S2JV/trabajo_fin_de_grado/01 - Simulaciones PSpice for TI 2024/01 - Resistencia de Shunt/002_offset_ai/002_OFFSET_AI.png

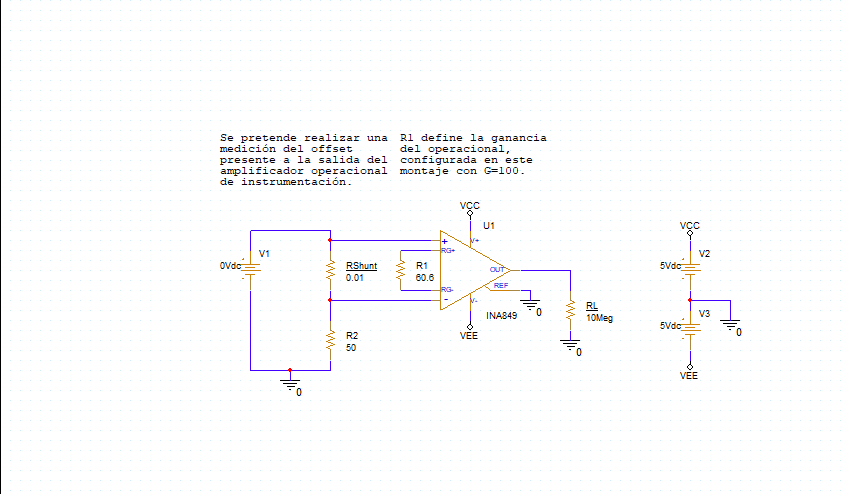
01 - Simulaciones PSpice for TI 2024/01 - Resistencia de Shunt/002_offset_ai/002_OFFSET_AI.png
