S2JV/trabajo_fin_de_grado/01 - Simulaciones PSpice for TI 2024/01 - Resistencia de Shunt/03_offset_ai_comp/03_OFFSET_AI_COMP.png

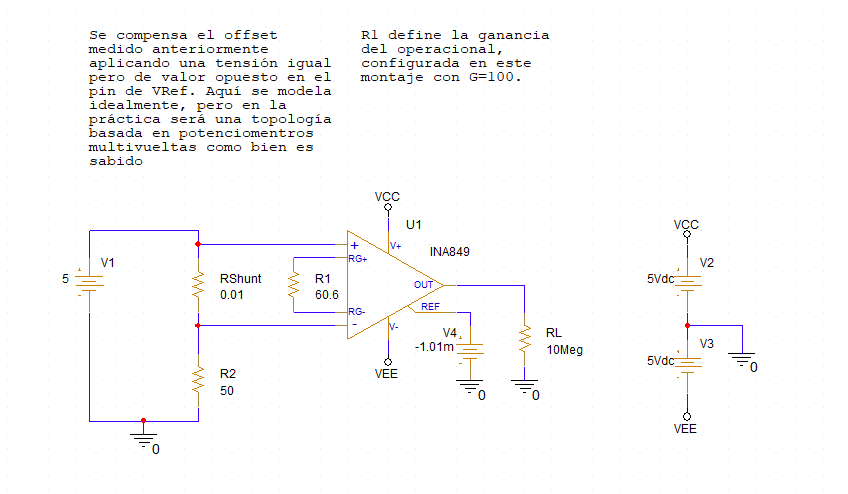
01 - Simulaciones PSpice for TI 2024/01 - Resistencia de Shunt/03_offset_ai_comp/03_OFFSET_AI_COMP.png
