S2JV/trabajo_fin_de_grado/01 - Simulaciones PSpice for TI 2024/01 - Resistencia de Shunt/004_corrientes_etapas/004_CORRIENTES_ETAPAS.png

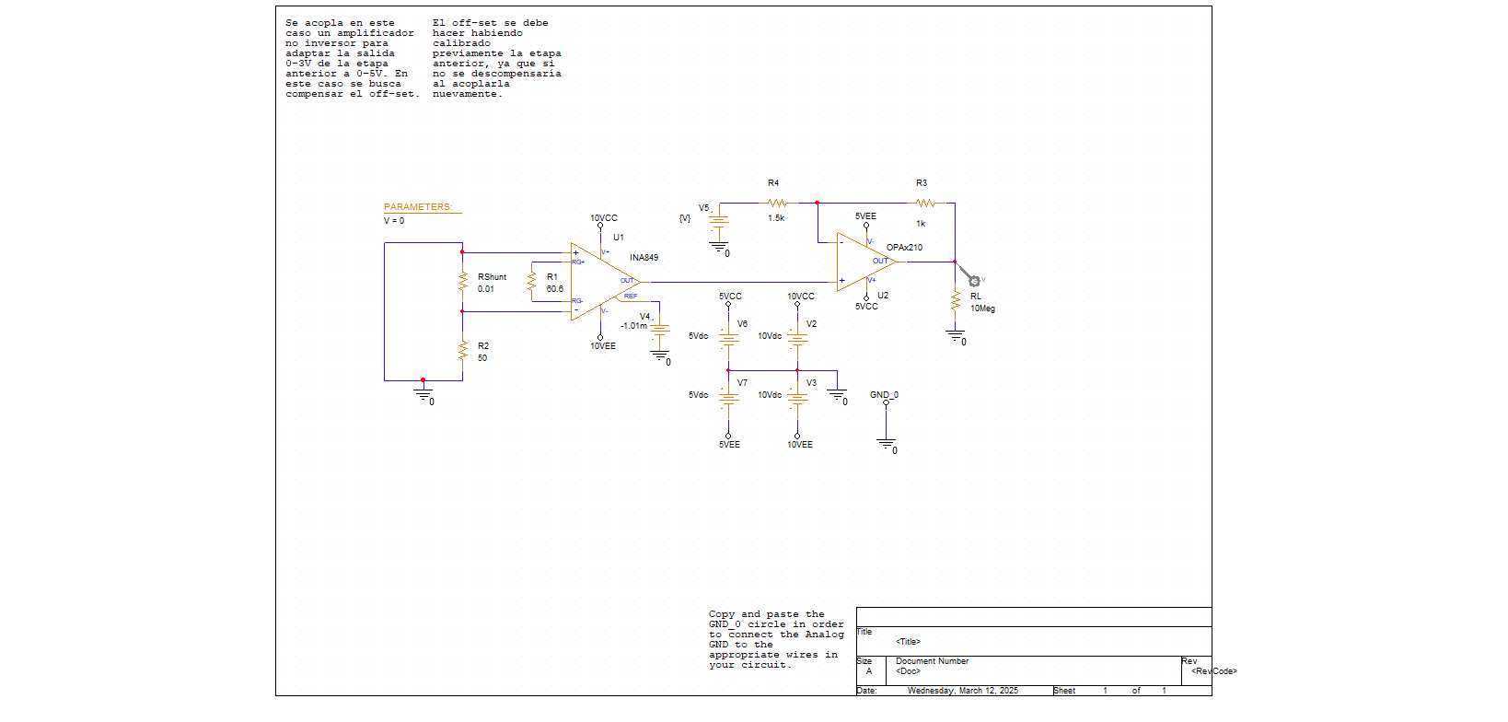
01 - Simulaciones PSpice for TI 2024/01 - Resistencia de Shunt/004_corrientes_etapas/004_CORRIENTES_ETAPAS.png
