S2JV/trabajo_fin_de_grado/01 - Simulaciones PSpice for TI 2024/01 - Resistencia de Shunt/005_corrientes_sim/005_CORREINES_SIM.png

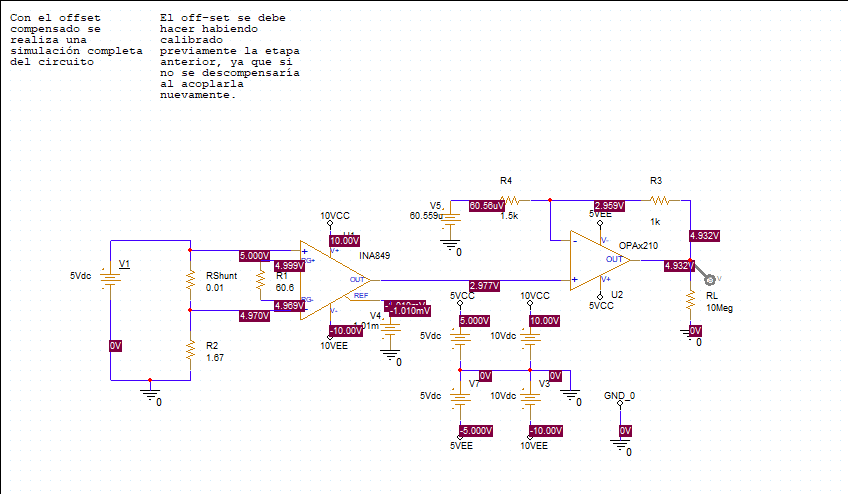
01 - Simulaciones PSpice for TI 2024/01 - Resistencia de Shunt/005_corrientes_sim/005_CORREINES_SIM.png
