S2JV/trabajo_fin_de_grado/01 - Simulaciones PSpice for TI 2024/02 - Voltímetro/001_dos_etapas_ideal/001_DOS_ETAPAS_IDEAL.png

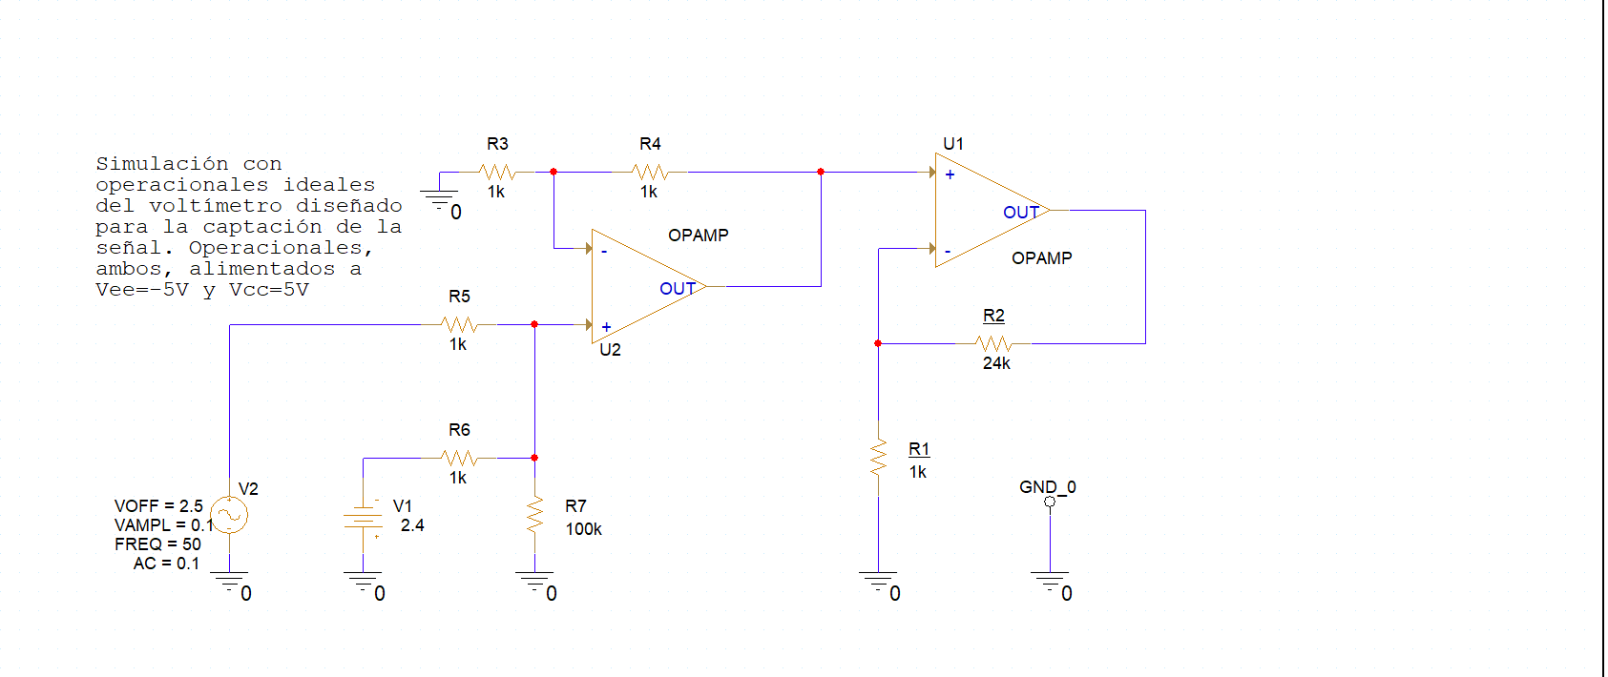
01 - Simulaciones PSpice for TI 2024/02 - Voltímetro/001_dos_etapas_ideal/001_DOS_ETAPAS_IDEAL.png
