S2JV/trabajo_fin_de_grado/01 - Simulaciones PSpice for TI 2024/02 - Voltímetro/002_dos_etapas_real/002_DOS_ETAPAS_REAL.png

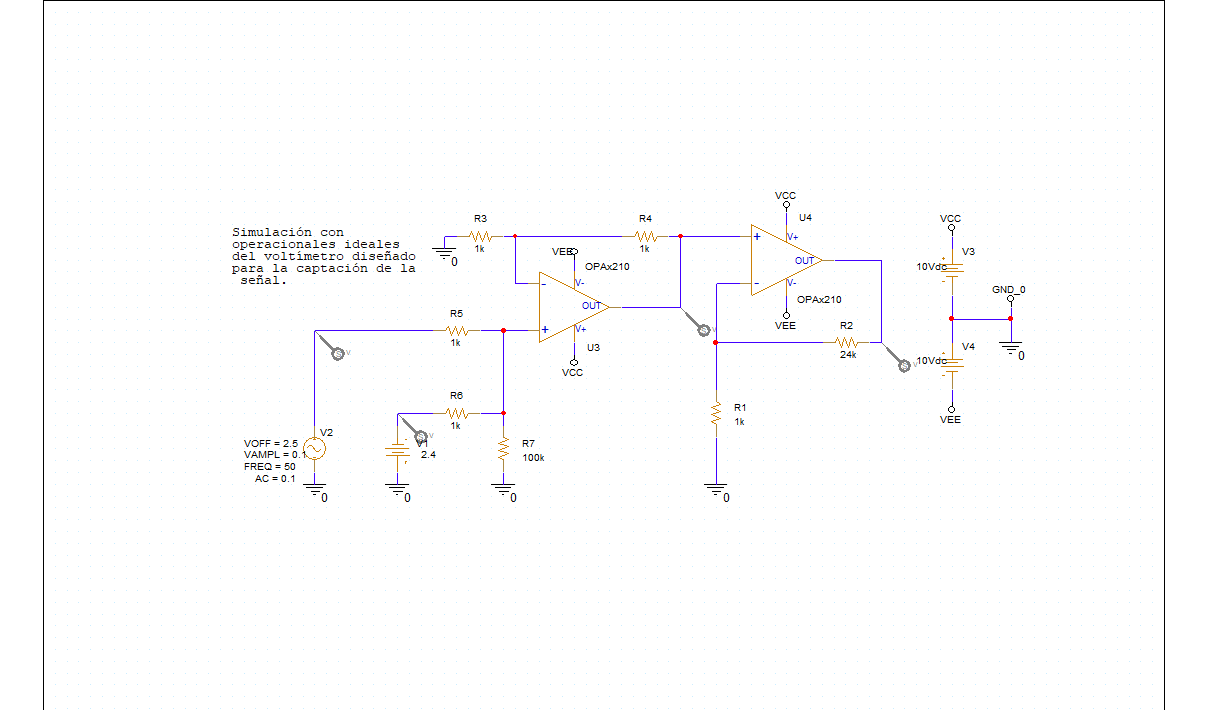
01 - Simulaciones PSpice for TI 2024/02 - Voltímetro/002_dos_etapas_real/002_DOS_ETAPAS_REAL.png
