S2JV/trabajo_fin_de_grado/01 - Simulaciones PSpice for TI 2024/02 - Voltímetro/003_etapa_uno_medicion_offset/003_ETAPA_UNO_MEDICION_OFFSET.png

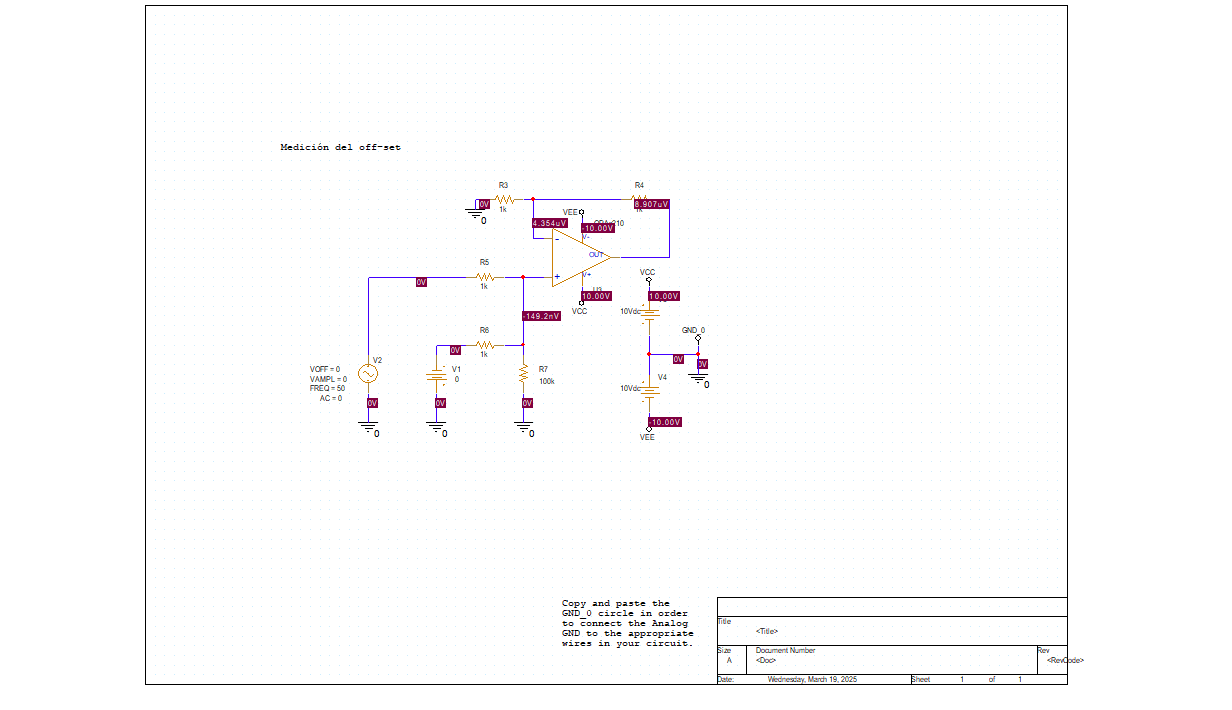
01 - Simulaciones PSpice for TI 2024/02 - Voltímetro/003_etapa_uno_medicion_offset/003_ETAPA_UNO_MEDICION_OFFSET.png
