S2JV/trabajo_fin_de_grado/01 - Simulaciones PSpice for TI 2024/02 - Voltímetro/004_etapa_uno_compensacion_offset/004_ETAPA_UNO_COMPENSACION_OFFSET.png

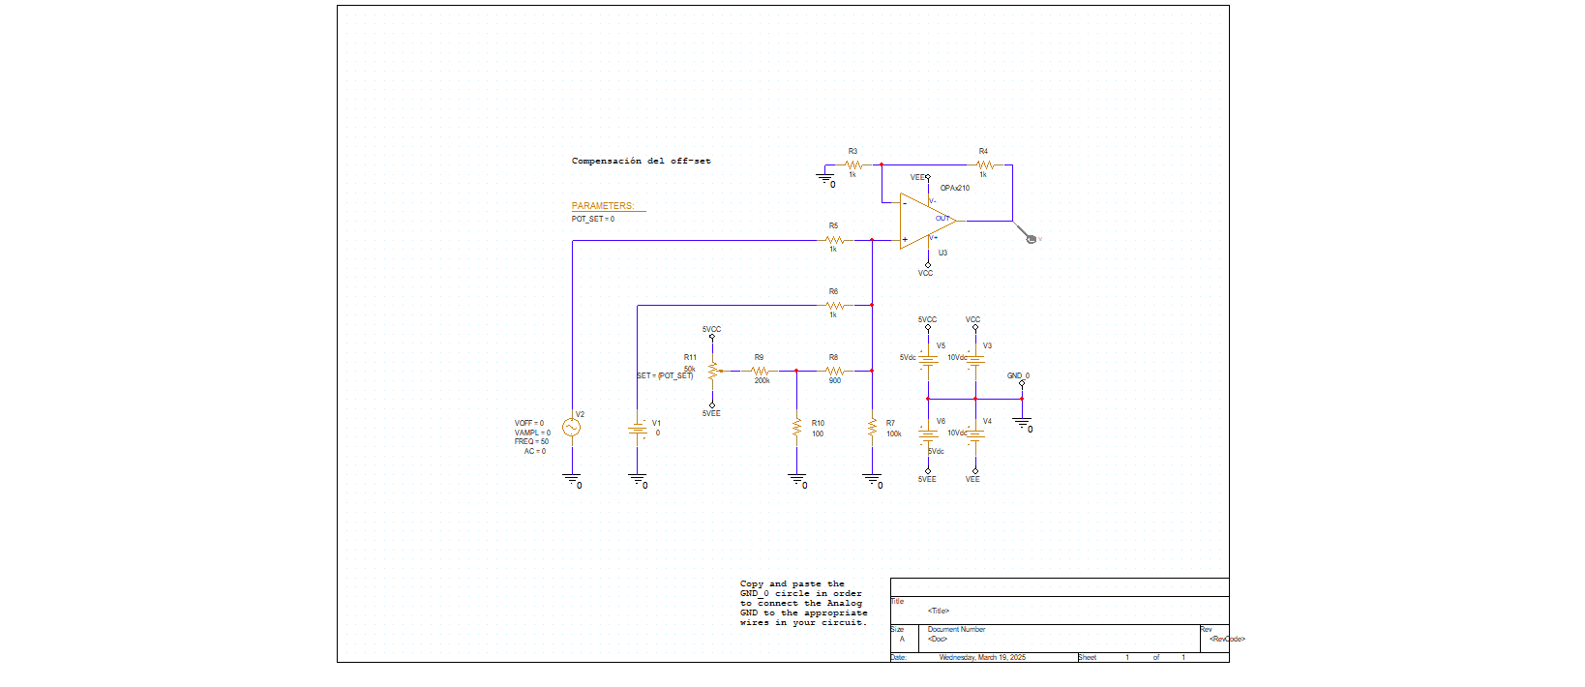
01 - Simulaciones PSpice for TI 2024/02 - Voltímetro/004_etapa_uno_compensacion_offset/004_ETAPA_UNO_COMPENSACION_OFFSET.png
