S2JV/trabajo_fin_de_grado/01 - Simulaciones PSpice for TI 2024/02 - Voltímetro/005_etapa_uno_compensado_sim/005_ETAPA_UNO_COMPENSADO_SIM.png

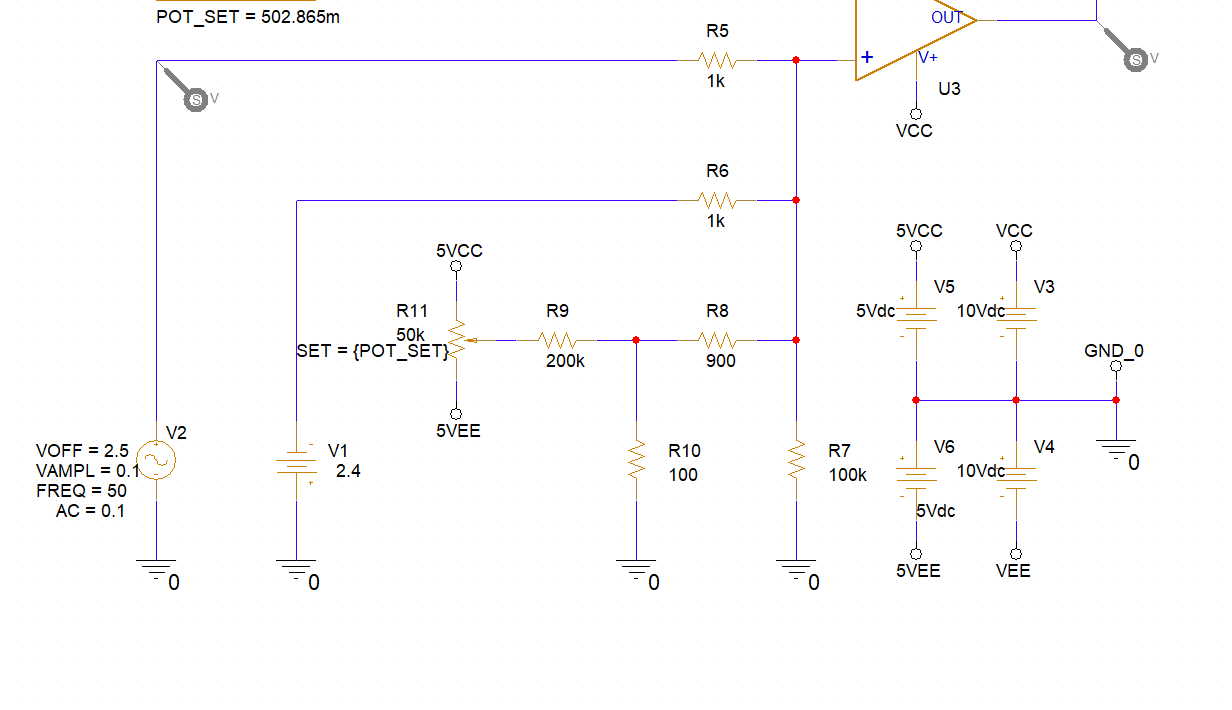
01 - Simulaciones PSpice for TI 2024/02 - Voltímetro/005_etapa_uno_compensado_sim/005_ETAPA_UNO_COMPENSADO_SIM.png
