S2JV/trabajo_fin_de_grado/(list of files, drawings)

Other design files:
01 - Simulaciones PSpice for TI 2024/01 - Resistencia de Shunt/002_offset_ai/002_offset_ai.dsn
01 - Simulaciones PSpice for TI 2024/01 - Resistencia de Shunt/002_offset_ai/002_offset_ai.opj
01 - Simulaciones PSpice for TI 2024/01 - Resistencia de Shunt/03_offset_ai_comp/03_offset_ai_comp.dsn
01 - Simulaciones PSpice for TI 2024/01 - Resistencia de Shunt/03_offset_ai_comp/03_offset_ai_comp.opj
01 - Simulaciones PSpice for TI 2024/01 - Resistencia de Shunt/004_corrientes_etapas/004_corrientes_etapas.dsn
01 - Simulaciones PSpice for TI 2024/01 - Resistencia de Shunt/004_corrientes_etapas/004_corrientes_etapas.opj
01 - Simulaciones PSpice for TI 2024/01 - Resistencia de Shunt/005_corrientes_sim/005_correines_sim.dsn
01 - Simulaciones PSpice for TI 2024/01 - Resistencia de Shunt/005_corrientes_sim/005_correines_sim.opj
01 - Simulaciones PSpice for TI 2024/02 - Voltímetro/001_dos_etapas_ideal/001_dos_etapas_ideal.dsn
01 - Simulaciones PSpice for TI 2024/02 - Voltímetro/001_dos_etapas_ideal/001_dos_etapas_ideal.opj
01 - Simulaciones PSpice for TI 2024/02 - Voltímetro/002_dos_etapas_real/002_dos_etapas_real.dsn
01 - Simulaciones PSpice for TI 2024/02 - Voltímetro/002_dos_etapas_real/002_dos_etapas_real.opj
01 - Simulaciones PSpice for TI 2024/02 - Voltímetro/003_etapa_uno_medicion_offset/003_etapa_uno_medicion_offset.dsn
01 - Simulaciones PSpice for TI 2024/02 - Voltímetro/003_etapa_uno_medicion_offset/003_etapa_uno_medicion_offset.opj
01 - Simulaciones PSpice for TI 2024/02 - Voltímetro/004_etapa_uno_compensacion_offset/004_etapa_uno_compensacion_offset.dsn
01 - Simulaciones PSpice for TI 2024/02 - Voltímetro/004_etapa_uno_compensacion_offset/004_etapa_uno_compensacion_offset.opj
01 - Simulaciones PSpice for TI 2024/02 - Voltímetro/005_etapa_uno_compensado_sim/005_etapa_uno_compensado_sim.dsn
01 - Simulaciones PSpice for TI 2024/02 - Voltímetro/005_etapa_uno_compensado_sim/005_etapa_uno_compensado_sim.opj
