S2JV/trabajo_fin_de_grado/04 - Archivos Fabricación/01 - Sistema de Medición/02 - KiCAD Board/rev_main_A.kicad_pcb

## KiCad design 04 - Archivos Fabricación/01 - Sistema de Medición/02 - KiCAD Board/rev_main_A.kicad_pcb (2025-11-10)

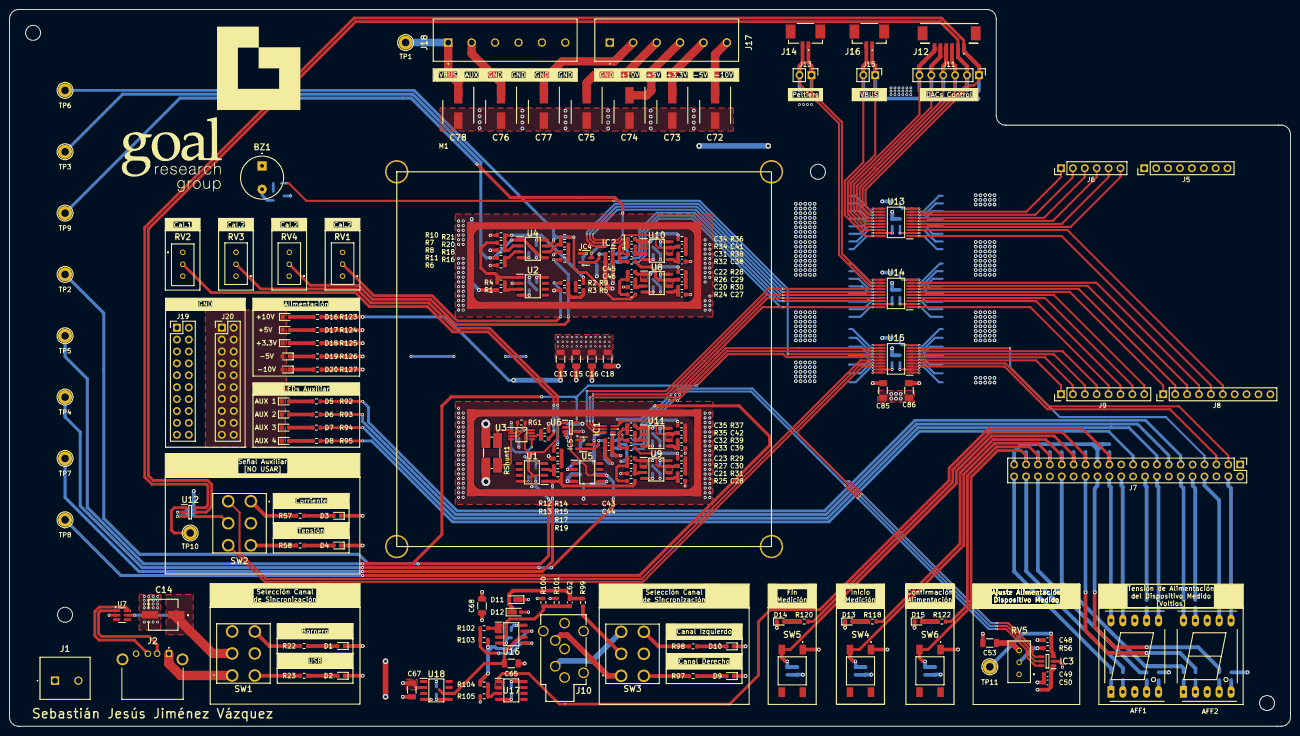
[picture p10: board rev_main_A.kicad_pcb from above]

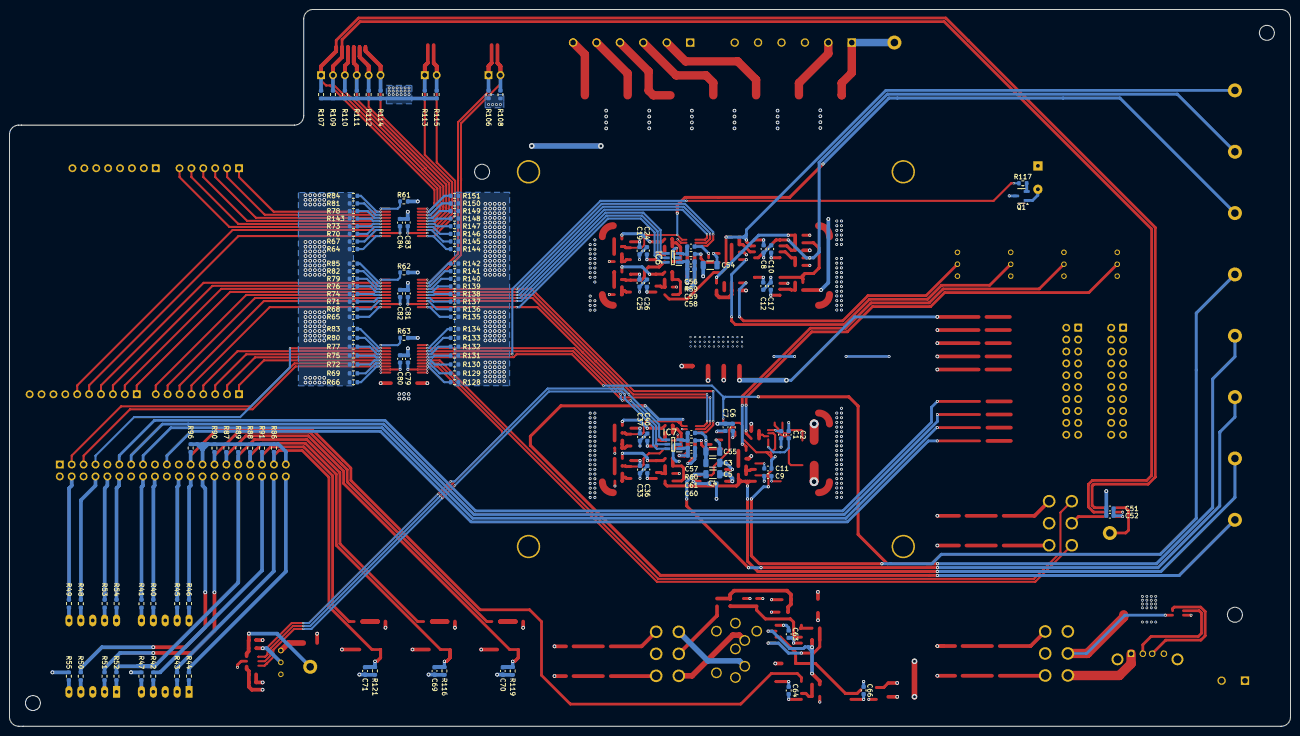
[picture p11: board rev_main_A.kicad_pcb from below]

Board: 4 copper layers, 273.5 x 153.0 mm, 334 parts (134 on the bottom side), 197 nets.

Parts:
AFF1, AFF2: TDSR1050; 7SegmentLED_LTS6760_LTS6780
BZ1: CMI-0955-05TH
C1, C2, C6, C7, C8, C9, C10, C11, C12, C17, C19, C24, C25, C26, C33, C36, C37, C40, C43, C45, C49, C51, C56, C57, C58, C60, C63, C64, C79, C80, C81, C82, C83, C84: 0.1u; C_0603_1608Metric
C3, C13, C15, C16, C18, C53, C54, C55, C65, C67, C68: 10u; C_1206_3216Metric
C4, C44, C46, C50, C52, C59, C61, C62, C66, C69, C70, C71: 1u; C_0603_1608Metric
C5: 47u; C_1206_3216Metric
C14: 100u; 865080343009
C20, C21: 100p; C_0603_1608Metric
C22, C23, C29, C30, C34, C35, C41, C42: 1n; C_0603_1608Metric
C27, C28: 430p; C_0603_1608Metric
C31, C32: 680p; C_0603_1608Metric
C38, C39: 910p; C_0603_1608Metric
C48: 15n; C_0603_1608Metric
C72, C73, C74, C75, C76, C77, C78: 47u; CAPAE660X770N
C85, C86: 10u; C_1206_3216Metric_Pad1.33x1.80mm_HandSolder
D1, D2, D3, D4, D5, D6, D7, D8, D9, D10, D13, D15: LED (G); LED_0603_1608Metric
D11, D12: 1V; D_MicroSMP_AK
D14, D16, D17, D18, D19, D20: LED (R); LED_0603_1608Metric
H1, H2, H3, H4: MountingHole; MountingHole_3.2mm_M3
IC1, IC2: AD7476AAKSZ-REEL7; AD7476AAKSZ
IC3, IC6, IC7: ADC121S021CIMFX/NOPB; ADC121S021CIMFXNOPB
IC4, IC5: TMP235A2DBZR; SOT-23-3
J1: Screw_Terminal_01x02; Screw Terminal 2P
J2: USB-1125-GF-B; USB1125GFB [USBA]
J3, J4: MS488-10C
J5: Arduino Power Shield; PinHeader_1x08_P2.54mm_Vertical
J6: Arduino Analog Shield; PinHeader_1x06_P2.54mm_Vertical
J7: Raspberry Pi Shield; PinHeader_2x20_P2.54mm_Vertical
J8: Arduino Digital Shield II; PinHeader_1x10_P2.54mm_Vertical
J9: Arduino Digital Shield I; PinHeader_1x08_P2.54mm_Vertical
J10: SJ1-3533NS; Conector Jack - SJ1-3533NS
J11: Pines; PinHeader_1x06_P2.54mm_Vertical
J12: PicoBlade 6P
J13, J15: PinHeader_1x02_P2.54mm_Vertical
J14, J16: PicoBlade 2P
J17, J18: Screw_Terminal_01x06; Screw Terminal 6P
J19, J20: Conn_02x07_Top_Bottom; PinHeader_2x10_P2.54mm_Vertical
M1: Fan; MC002110
Q1: MMBT4401; SOT-23-3
R1, R4, R6, R7, R8, R11, R19, R40, R41, R42, R43, R44, R45, R46, R47, R48, R49, R50, R51, R52, R53, R54, R55, R116, R117, R119, R121: 1k; R_0603_1608Metric
R2, R13, R14, R16: 200k; R_0603_1608Metric
R3, R12, R15, R18, R59, R60: 100; R_0603_1608Metric
R5, R20: 900; R_0603_1608Metric
R9, R99: 0; R_0603_1608Metric
R10, R103, R105: 100k; R_0603_1608Metric
R17: 1k4; R_0603_1608Metric
R21: 24k; R_0603_1608Metric
R22, R23, R57, R58, R92, R93, R94, R95, R97, R98, R118, R120, R122, R125: 130; R_0603_1608Metric
R24, R25: 1.1k; R_0603_1608Metric
R26, R27: 4.87k; R_0603_1608Metric
R28, R29: 845; R_0603_1608Metric
R30, R31: 1.82k; R_0603_1608Metric
R32, R33: 698; R_0603_1608Metric
R34, R35: 1.58k; R_0603_1608Metric
R36, R37: 715; R_0603_1608Metric
R38, R39: 1.21k; R_0603_1608Metric
R56, R61, R62, R63, R64, R65, R66, R67, R68, R69, R70, R71, R72, R73, R74, R75, R76, R77, R78, R79, R80, R81, R82, R83, R84, R85, R86, R87, R88, R89, R90, R91, R96, R102, R128, R129, R130, R131, R132, R133, R134, R135, R136, R137, R138, R139, R140, R141, R142, R143, R144, R145, R146, R147, R148, R149, R150, R151: 10k; R_0603_1608Metric
R100, R101: 32k; R_0603_1608Metric
R104: 51.5k; R_0603_1608Metric
R106, R107, R108, R109, R110, R111, R112, R113, R114, R115: R; R_0603_1608Metric
R123, R126: 800; R_0603_1608Metric
R124, R127: 300; R_0603_1608Metric
RG1: 60.6; R_0603_1608Metric
RShunt1: 10m; R_Shunt_Ohmite_LVK24
RV1, RV2, RV3, RV4, RV5: 50k; PV36W201C01B00
SW1, SW2, SW3: 100DP1T1B1M2QEH; SW Palanca 100DP1T1B1M2QEH
SW4, SW5, SW6: SW_Push; SW Tactile
TP1, TP2, TP3, TP4, TP5, TP6, TP7, TP8, TP9, TP10, TP11: TestPoint; TestPoint_Loop_D2.60mm_Drill1.6mm_Beaded
U1, U2, U4, U16, U17: OPA210IDBVR; OPA2107AU2K5
U3: INA849DGKT
U5: REF5030AIDR
U6: TLV3601QDBVRQ1
U7: IP4234CZ6,125; SC-74-6_1.55x2.9mm_P0.95mm
U8, U9, U10, U11: AD8656ARZ
U12: DAC121S101CIMK_NOPB
U13, U14, U15: TXS0108EPWRG4
U18: REF5025AIDR; REF5030AIDR

Connections:
+3.3V: C74.1, C80.1, C82.1, C84.1, C86.1, J5.5, J5.7, J7.1, J7.17, J17.4, R47.1, R61.1, R62.1, R63.1, R125.2, SW1.5 (B), SW2.2 (B), SW3.5 (B), SW4.1, SW5.1, SW6.1, U13.2 (VCCA), U14.2 (VCCA), U15.2 (VCCA)
+5V: BZ1.1 (+), C3.1, C6.1, C16.1, C19.1, C25.1, C33.1, C37.1, C43.2, C44.2, C45.2, C46.2, C49.2, C50.2, C51.2, C52.2, C53.1, C54.1, C55.1, C58.2, C59.2, C60.2, C61.2, C63.1, C64.1, C67.1, C68.1, C75.1, C79.1, C81.1, C83.1, C85.1, IC1.1 (VDD), IC2.1 (VDD), IC3.1 (VDD), IC4.1 (VDD), IC5.1 (VDD), IC6.1 (VDD), IC7.1 (VDD), J5.4, J7.2, J17.3, R100.1, R124.2, RV1.1, RV2.3, RV3.1, RV4.1, RV5.3, U5.2 (Vin), U6.3 (V+), U8.8 (V+), U9.8 (V+), U10.8 (V+), U11.8 (V+), U12.3 (VA), U13.19 (VCCB), U14.19 (VCCB), U15.19 (VCCB), U16.8 (V+), U17.8 (V+), U18.2 (Vin)
+10V: C1.2, C8.1, C9.1, C12.1, C13.1, C77.1, J17.2, R123.2, U1.8 (V+), U2.8 (V+), U3.8 (Vs+), U4.8 (V+)
-5V: C7.1, C18.1, C24.1, C26.1, C36.1, C40.1, C73.1, J17.5, R127.2, RV1.3, RV2.1, RV3.3, RV4.3, U6.4 (V-), U8.4 (V-), U9.4 (V-), U10.4 (V-), U11.4 (V-)
-10V: C2.2, C10.1, C11.1, C15.1, C17.1, C72.1, J17.6, R126.2, U1.4 (V-), U2.4 (V-), U3.5 (Vs-), U4.4 (V-)
/006_Conn_FPGA1/BUZZER_{FPGA}: J9.3, R77.1, U15.7 (A6)
/006_Conn_FPGA1/CD_{BUS,ADC,FPGA}: J9.5, R65.1, U14.1 (A1)
/006_Conn_FPGA1/CLK_{4MHz,FPGA}: J9.7, R71.1, U14.4 (A3)
/006_Conn_FPGA1/CLK_{ADC,FPGA}: J9.8, R74.1, U14.5 (A4)
/006_Conn_FPGA1/CLK_{DAC,FPGA}: J6.2, R81.1, U13.8 (A7)
/006_Conn_FPGA1/CS_{ADC,FPGA}: J8.2, R79.1, U14.7 (A6)
/006_Conn_FPGA1/DATA_{BUS,ADC,FPGA}: J7.5, R66.1, U15.3 (A2)
/006_Conn_FPGA1/DATA_{I,ADC,FPGA}: J9.4, R80.1, U15.8 (A7)
/006_Conn_FPGA1/DATA_{TEMP,I,FPGA}: J7.7, R83.1, U15.9 (A8)
/006_Conn_FPGA1/DATA_{TEMP,V,FPGA}: J9.6, R68.1, U14.3 (A2)
/006_Conn_FPGA1/DATA_{V,ADC,FPGA}: J8.1, R76.1, U14.6 (A5)
/006_Conn_FPGA1/DIN_{DAC,AUX,FPGA}: J6.6, R70.1, U13.4 (A3)
/006_Conn_FPGA1/DIN_{DAC,BUS,FPGA}: J6.5, R73.1, U13.5 (A4)
/006_Conn_FPGA1/DIN_{DAC,PEL,I,FPGA}: J6.3, R78.1, U13.7 (A6)
/006_Conn_FPGA1/DIN_{DAC,PEL,V,FPGA}: J6.4, R143.1, U13.6 (A5)
/006_Conn_FPGA1/DIN_{I,AUX,FPGA}: J7.3, R69.1, U15.4 (A3)
/006_Conn_FPGA1/DIN_{V,AUX,FPGA}: J9.1, R72.1, U15.5 (A4)
/006_Conn_FPGA1/ENABLE_{BUS,AUX,FPGA}: J8.6, R67.1, U13.3 (A2)
/006_Conn_FPGA1/ENABLE_{BUS,FPGA}: J8.5, R64.1, U13.1 (A1)
/006_Conn_FPGA1/ENABLE_{PEL,I,FPGA}: J8.4, R85.1, U14.9 (A8)
/006_Conn_FPGA1/ENABLE_{PEL,V,FPGA}: J8.3, R82.1, U14.8 (A7)
/006_Conn_FPGA1/LED_{AUX,1}: J7.11, R92.2
/006_Conn_FPGA1/LED_{AUX,2}: J7.13, R93.2
/006_Conn_FPGA1/LED_{AUX,3}: J7.15, R94.2
/006_Conn_FPGA1/LED_{AUX,4}: J7.19, R95.2
/006_Conn_FPGA1/Protection_{Trigger,FPGA}: J9.2, R75.1, U15.6 (A5)
/006_Conn_FPGA1/SYNC_{DAC,FPGA}: J6.1, R84.1, U13.9 (A8)
ADC_{I,In}: C42.2, IC1.3 (VIN), TP8.1, U11.6 (-), U11.7
ADC_{V,In}: C41.2, IC2.3 (VIN), TP9.1, U10.6 (-), U10.7
BUZZER: R117.2, R132.1, U15.14 (B6)
CLK_{4MHz}: IC3.4 (SCLK), IC6.4 (SCLK), IC7.4 (SCLK), R137.1, U14.17 (B3)
CLK_{ADC}: IC1.4 (SCLK), IC2.4 (SCLK), R138.1, U14.16 (B4)
CLK_{DAC}: J11.2, J12.2, R109.1, R150.1, U12.5 (SCLK), U13.13 (B7)
CS_{ADC}: IC1.6 (~CS), IC2.6 (~CS), R140.1, U14.14 (B6)
CS_{BUS,ADC}: IC3.6 (~CS), IC6.6 (~CS), IC7.6 (~CS), R135.1, U14.20 (B1)
DATA_{BUS,ADC}: IC3.5 (SDATA), R128.1, U15.18 (B2)
DATA_{I,ADC}: IC1.5 (SDATA), R133.1, U15.13 (B7)
DATA_{TEMP,I}: IC7.5 (SDATA), R134.1, U15.12 (B8)
DATA_{TEMP,V}: IC6.5 (SDATA), R136.1, U14.18 (B2)
DATA_{V,ADC}: IC2.5 (SDATA), R139.1, U14.15 (B5)
DIN_{DAC,AUX}: J11.6, J12.6, R114.1, R146.1, U13.17 (B3)
DIN_{DAC,BUS}: J11.5, J12.5, R112.1, R147.1, U13.16 (B4)
DIN_{DAC,PEL,I}: J11.3, J12.3, R110.1, R149.1, U13.14 (B6)
DIN_{DAC,PEL,V}: J11.4, J12.4, R111.1, R148.1, U13.15 (B5)
DIN_{I,AUX}: R129.1, SW2.6 (C), U15.17 (B3)
DIN_{V,AUX}: R130.1, SW2.4 (A), U15.16 (B4)
Display1_{a}: J7.18, R40.1
Display1_{b}: J7.16, R41.1
Display1_{c}: J7.36, R42.1
Display1_{d}: J7.38, R43.1
Display1_{e}: J7.40, R44.1
Display1_{f}: J7.22, R45.1
Display1_{g}: J7.24, R46.1
Display2_{a}: J7.8, R48.1
Display2_{b}: J7.4, R49.1
Display2_{c}: J7.26, R50.1
Display2_{d}: J7.28, R51.1
Display2_{e}: J7.32, R52.1
Display2_{f}: J7.10, R53.1
Display2_{g}: J7.12, R54.1
ENABLE_{BUS,AUX}: J15.1, J16.1, R113.1, R145.1, U13.18 (B2)
ENABLE_{BUS}: J15.2, J16.2, R115.1, R144.1, U13.20 (B1)
ENABLE_{PEL,I}: J13.1, J14.1, R106.1, R142.1, U14.12 (B8)
ENABLE_{PEL,V}: J13.2, J14.2, R108.1, R141.1, U14.13 (B7)
GND: AFF1.3 (C.A.), AFF1.8 (C.A.), AFF2.3 (C.A.), AFF2.8 (C.A.), C1.1, C2.1, C3.2, C4.2, C5.2, C6.2, C7.2, C8.2, C9.2, C10.2, C11.2, C12.2, C13.2, C14.2, C15.2, C16.2, C17.2, C18.2, C19.2, C20.2, C21.2, C24.2, C25.2, C26.2, C27.2, C28.2, C31.2, C32.2, C33.2, C36.2, C37.2, C38.2, C39.2, C40.2, C43.1, C44.1, C45.1, C46.1, C48.2, C49.1, C50.1, C51.1, C52.1, C53.2, C54.2, C55.2, C56.2, C57.2, C58.1, C59.1, C60.1, C61.1, C63.2, C64.2, C65.2, C66.2, C67.2, C68.2, C69.2, C70.2, C71.2, C72.2, C73.2, C74.2, C75.2, C76.2, C77.2, C78.2, C79.2, C80.2, C81.2, C82.2, C83.2, C84.2, C85.2, C86.2, D1.1 (K), D2.1 (K), D3.1 (K), D4.1 (K), D5.1 (K), D6.1 (K), D7.1 (K), D8.1 (K), D9.1 (K), D10.1 (K), D11.1 (K), D12.2 (A), D13.1 (K), D14.1 (K), D15.1 (K), D16.1 (K), D17.1 (K), D18.1 (K), D19.2 (A), D20.2 (A), IC1.2 (GND), IC2.2 (GND), IC3.2 (GND), IC4.3 (GND), IC5.3 (GND), IC6.2 (GND), IC7.2 (GND), J1.1, J2.4 (GND), J2.5 (Shield), J3.1 (Shield), J4.1 (Shield), J5.2, J5.3, J7.6, J7.9, J7.14, J7.20, J7.25, J7.30, J7.34, J7.39, J8.7, J10.1, J17.1, J18.3, J18.4, J18.5, J18.6, J19.1, J19.2, J19.3, J19.4, J19.5, J19.6, J19.7, J19.8, J19.9, J19.10, J19.11, J19.12, J19.13, J19.14, J19.15, J19.16, J19.17, J19.18, J19.19, J19.20, J20.1, J20.2, J20.3, J20.4, J20.5, J20.6, J20.7, J20.8, J20.9, J20.10, J20.11, J20.12, J20.13, J20.14, J20.15, J20.16, J20.17, J20.18, J20.19, J20.20, M1.1 (+), Q1.3 (E), R3.1, R6.1, R10.1, R12.1, R15.2, R18.2, R55.1, R64.2, R65.2, R66.2, R67.2, R68.2, R69.2, R70.2, R71.2, R72.2, R73.2, R74.2, R75.2, R76.2, R77.2, R78.2, R79.2, R80.2, R81.2, R82.2, R83.2, R84.2, R85.2, R86.2, R87.2, R88.2, R89.2, R90.2, R91.2, R96.2, R101.2, R105.2, R106.2, R107.2, R108.2, R109.2, R110.2, R111.2, R112.2, R113.2, R114.2, R115.2, R116.2, R119.2, R121.2, R128.2, R129.2, R130.2, R131.2, R132.2, R133.2, R134.2, R135.2, R136.2, R137.2, R138.2, R139.2, R140.2, R141.2, R142.2, R143.2, R144.2, R145.2, R146.2, R147.2, R148.2, R149.2, R150.2, R151.2, RV5.1, U2.2 (-), U5.4 (GND), U7.2 (VN), U12.2 (GND), U13.11 (GND), U14.11 (GND), U15.11 (GND), U16.4 (V-), U17.4 (V-), U18.4 (GND)
I_{Measure}: R19.2, R25.1, TP7.1, U1.1
unnamed: AFF1.5 (DP), R47.2
unnamed: AFF1.7 (a), R40.2
unnamed: AFF1.6 (b), R41.2
unnamed: AFF1.4 (c), R42.2
unnamed: AFF1.2 (d), R43.2
unnamed: AFF1.1 (e), R44.2
unnamed: AFF1.9 (f), R45.2
unnamed: AFF1.10 (g), R46.2
unnamed: AFF2.5 (DP), R55.2
unnamed: AFF2.7 (a), R48.2
unnamed: AFF2.6 (b), R49.2
unnamed: AFF2.4 (c), R50.2
unnamed: AFF2.2 (d), R51.2
unnamed: AFF2.1 (e), R52.2
unnamed: AFF2.9 (f), R53.2
unnamed: AFF2.10 (g), R54.2
unnamed: BZ1.2 (-), Q1.1 (C)
unnamed: C22.1, R24.2, R26.1
unnamed: C23.1, R25.2, R27.1
unnamed: C29.1, R28.2, R30.1
unnamed: C30.1, R29.2, R31.1
unnamed: C34.1, R32.2, R34.1
unnamed: C35.1, R33.2, R35.1
unnamed: C41.1, R36.2, R38.1
unnamed: C42.1, R37.2, R39.1
unnamed: D1.2 (A), R22.1
unnamed: D2.2 (A), R23.1
unnamed: D3.2 (A), R57.1
unnamed: D4.2 (A), R58.1
unnamed: D5.2 (A), R92.1
unnamed: D6.2 (A), R93.1
unnamed: D7.2 (A), R94.1
unnamed: D8.2 (A), R95.1
unnamed: D9.2 (A), R97.1
unnamed: D10.2 (A), R98.1
unnamed: C62.1, D11.2 (A), D12.1 (K), R99.2
unnamed: D13.2 (A), R118.1
unnamed: D14.2 (A), R120.1
unnamed: D15.2 (A), R122.1
unnamed: D16.2 (A), R123.1
unnamed: D17.2 (A), R124.1
unnamed: D18.2 (A), R125.1
unnamed: D19.1 (K), R126.1
unnamed: D20.1 (K), R127.1
unnamed: C48.1, IC3.3 (VIN), R56.2, TP11.1
unnamed: IC4.2 (VOUT), R59.1
unnamed: IC5.2 (VOUT), R60.1
unnamed: C56.1, IC6.3 (VIN), R59.2
unnamed: C57.1, IC7.3 (VIN), R60.2
unnamed: J1.2, SW1.3 (C)
unnamed: J2.3 (D+), U7.6
unnamed: J2.2 (D-), U7.1
unnamed: J2.1 (VBUS), SW1.1 (A)
unnamed: J10.2, SW3.3 (C)
unnamed: J10.3, SW3.1 (A)
unnamed: Q1.2 (B), R117.1
unnamed: R2.1, RV1.2
unnamed: R2.2, R3.2, R5.1
unnamed: R4.2, R7.1, U2.1
unnamed: R5.2, R9.1
unnamed: R13.2, RV2.2
unnamed: R14.1, RV3.2
unnamed: R14.2, R15.1, R17.1
unnamed: R16.1, RV4.2
unnamed: R16.2, R18.1, R20.2
unnamed: R22.2, SW1.6 (C)
unnamed: R23.2, SW1.4 (A)
unnamed: R56.1, RV5.2
unnamed: R57.2, SW2.1 (A)
unnamed: R58.2, SW2.3 (C)
unnamed: R97.2, SW3.4 (A)
unnamed: R98.2, SW3.6 (C)
unnamed: R99.1, SW3.2 (B)
unnamed: R103.2, R104.1, U16.7
unnamed: RG1.1, U3.2 (Rg)
unnamed: RG1.2, U3.3 (Rg)
unnamed: R17.2, R19.1, U1.3 (+)
unnamed: TP2.1, U1.2 (-), U3.7, U6.1 (+)
unnamed: R1.2, R4.1, U2.3 (+)
unnamed: RShunt1.3, U3.4 (+)
unnamed: RShunt1.2, U3.1 (-)
unnamed: R12.2, R13.1, U3.6 (Ref)
unnamed: R6.2, R11.1, U4.3 (+)
unnamed: R7.2, R8.2, R9.2, R10.2, U4.2 (-)
unnamed: R11.2, TP3.1, U4.1, U4.5 (+)
unnamed: R20.1, R21.1, U4.6 (-)
unnamed: C4.1, U5.5 (Trim/NR)
unnamed: C5.1, TP4.1, U5.6 (Vout), U6.2 (-)
unnamed: C20.1, R26.2, U8.3 (+)
unnamed: C22.2, R28.1, U8.1, U8.2 (-)
unnamed: C27.1, R30.2, U8.5 (+)
unnamed: C29.2, R32.1, U8.6 (-), U8.7
unnamed: C21.1, R27.2, U9.3 (+)
unnamed: C23.2, R29.1, U9.1, U9.2 (-)
unnamed: C28.1, R31.2, U9.5 (+)
unnamed: C30.2, R33.1, U9.6 (-), U9.7
unnamed: C31.1, R34.2, U10.3 (+)
unnamed: C34.2, R36.1, U10.1, U10.2 (-)
unnamed: C38.1, R38.2, U10.5 (+)
unnamed: C32.1, R35.2, U11.3 (+)
unnamed: C35.2, R37.1, U11.1, U11.2 (-)
unnamed: C39.1, R39.2, U11.5 (+)
unnamed: SW2.5 (B), U12.4 (DIN)
unnamed: TP10.1, U12.1 (VOUT)
unnamed: R61.2, U13.10 (OE)
unnamed: R62.2, U14.10 (OE)
unnamed: R63.2, U15.10 (OE)
unnamed: C62.2, R100.2, R101.1, U16.3 (+)
unnamed: R102.1, U16.1, U16.2 (-)
unnamed: R102.2, R103.1, U16.5 (+)
unnamed: C65.1, U16.6 (-), U18.6 (Vout)
unnamed: R104.2, R105.1, U17.3 (+)
unnamed: C66.1, U18.5 (Trim/NR)
Protection_{Trigger}: R131.1, TP5.1, U6.5, U15.15 (B5)
READY_{VBUS,LED}: J7.35, R91.1, R122.2
READY_{VBUS}: C71.1, J7.37, R86.1, R121.1, SW6.2
START_{LED}: J7.31, R89.1, R118.2
START_{MEASURE}: C69.1, J7.33, R88.1, R116.1, SW4.2
STOP_{LED}: J7.27, R90.1, R120.2
STOP_{MEASURE}: C70.1, J7.29, R87.1, R119.1, SW5.2
SYNC_{DAC}: J11.1, J12.1, R107.1, R151.1, U12.6 (SYNC), U13.12 (B8)
SYNC_{MEASURE}: J7.23, R96.1, U17.1, U17.2 (-)
VBUS: C78.1, J18.1, R8.1, RShunt1.1, TP1.1
VBUS_{USB}: C14.1, RShunt1.4, SW1.2 (B), U7.5 (VP)
V_{BUS,AUX}: C76.1, J18.2, R1.1
V_{Measure}: R21.2, R24.1, TP6.1, U4.7
