S2JV/trabajo_fin_de_grado/04 - Archivos Fabricación/02 - Sistema de Alimentación/02 - KiCAD Board/rev_power_A.kicad_pcb

## KiCad design 04 - Archivos Fabricación/02 - Sistema de Alimentación/02 - KiCAD Board/rev_power_A.kicad_pcb (2025-11-10)

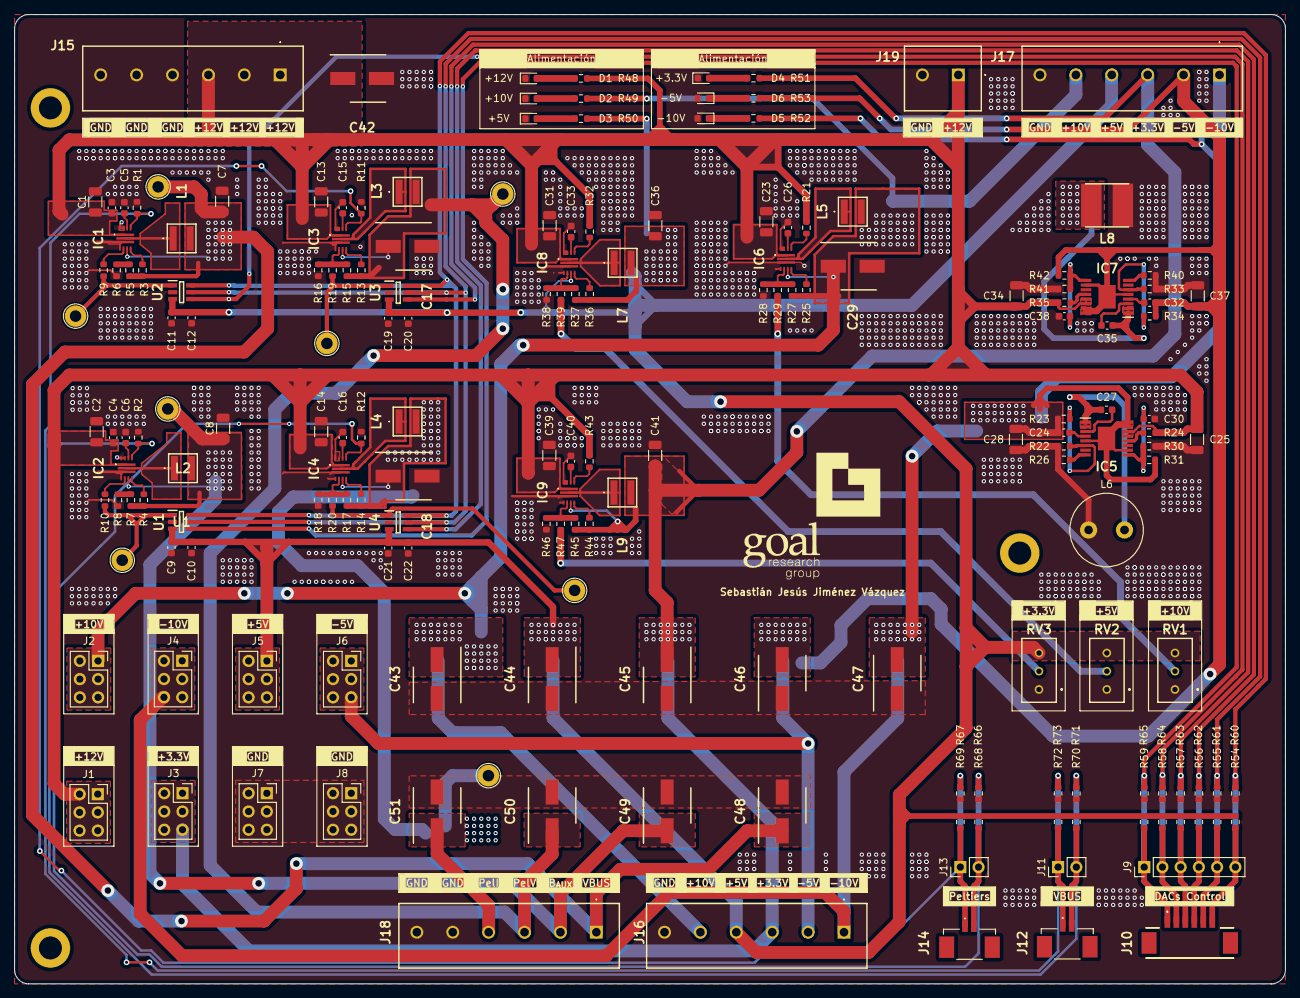
[picture p12: board rev_power_A.kicad_pcb from above]

Board: 2 copper layers, 177.0 x 135.0 mm, 185 parts (0 on the bottom side), 81 nets.

Parts:
C1, C2, C13, C14, C23, C25, C31, C34, C39: 10u; C_1206_3216Metric
C3, C4, C9, C11, C19, C21: 0.1u; C_0603_1608Metric
C5, C6, C15, C16, C26, C33, C40: 2.2n; C_0603_1608Metric
C7, C8, C36, C41: 47u; C_1206_3216Metric
C10, C12, C20, C22: 1u; C_0603_1608Metric
C17, C18, C29, C42, C43, C44, C45, C46, C47, C48, C49, C50, C51: 47u; CAPAE660X770N
C24, C32: 2.2u; C_0603_1608Metric
C27, C35: 470n; C_0603_1608Metric
C28, C37: 4.7u; C_1206_3216Metric
C30: 180p; C_0603_1608Metric
C38: 56p; C_0603_1608Metric
D1, D2, D3, D4, D5, D6: LED (R); LED_0603_1608Metric
H1, H2, H3: MountingHole; MountingHole_3.2mm_M3_ISO14580_Pad
IC1, IC2: TPS621361; TPS621361RGXT
IC3, IC4, IC6, IC8, IC9: TPS62136RGXR; TPS621361RGXT
IC5, IC7: LM43601PWPR; SOP65P640X120-17N
J1, J2, J3, J4, J5, J6, J7, J8: Conn_02x03_Counter_Clockwise; PinSocket_2x03_P2.54mm_Vertical
J9: PicoBlade 6P; PinHeader_1x06_P2.54mm_Vertical
J10: PicoBlade 6P
J11, J13: PicoBlade 2P; PinHeader_1x02_P2.54mm_Vertical
J12, J14: PicoBlade 2P
J15, J16, J17, J18: Screw_Terminal_01x06; Screw Terminal 6P
J19: Screw Terminal 2P
L1, L2, L3, L4, L5, L7, L9: 1.5u; XAL4020152MEC
L6: 47u; L_Radial_D10.0mm_P5.00mm_Neosid_SD12_style3
L8: 33u; INDM6060X450N
R1, R2, R11, R12, R21, R24, R32, R35, R43: 10k; R_0603_1608Metric
R3, R4, R13, R14, R25, R26, R36, R40, R44: 100k; R_0603_1608Metric
R5, R7: 619k; R_0603_1608Metric
R6, R8: 95.3k; R_0603_1608Metric
R9, R10: 768k; R_0603_1608Metric
R15, R17: 953k; R_0603_1608Metric
R16, R18, R31: 113k; R_0603_1608Metric
R19, R20: 732k; R_0603_1608Metric
R22, R23, R33, R34: 0; R_0603_1608Metric
R27: 1.47M; R_0603_1608Metric
R28, R38: 102k; R_0603_1608Metric
R29, R39, R47: 2M; R_0603_1608Metric
R30, R41: 1M; R_0603_1608Metric
R37: 750k; R_0603_1608Metric
R42: 255k; R_0603_1608Metric
R45: 511k; R_0603_1608Metric
R46: 105k; R_0603_1608Metric
R48, R49, R50, R51, R52, R53: 130; R_0603_1608Metric
R54, R55, R56, R57, R58, R59, R60, R61, R62, R63, R64, R65, R66, R67, R68, R69, R70, R71, R72, R73: R; R_0603_1608Metric
RV1, RV2, RV3: 50k; PV36W201C01B00
TP1, TP2, TP3, TP4, TP5, TP6, TP7, TP8: TestPoint; TestPoint_Loop_D2.60mm_Drill1.6mm_Beaded
U1, U2, U3, U4: DAC121S101CIMK/NOPB; SOT-23-THIN-6

Connections:
+3.3V: C41.1, C45.1, IC9.6 (VOS), J3.1, J3.2, J3.3, J3.4, J3.5, J3.6, J16.3, J17.3, L9.2, R44.2, R45.1, R51.2
+5V: C9.2, C10.2, C11.2, C12.2, C19.2, C20.2, C21.2, C22.2, C36.1, C44.1, IC8.6 (VOS), J5.1, J5.2, J5.3, J5.4, J5.5, J5.6, J16.4, J17.4, L7.2, R36.2, R37.1, R50.2, R54.1, R55.1, R56.1, R57.1, R58.1, R59.1, R68.1, R69.1, R70.1, R72.1, RV1.3, RV2.3, RV3.3, U1.3 (VA), U2.3 (VA), U3.3 (VA), U4.3 (VA)
+10V: C29.1, C43.1, IC6.6 (VOS), J2.1, J2.2, J2.3, J2.4, J2.5, J2.6, J16.5, J17.5, L5.2, R25.2, R27.1, R49.2
+12V: C1.1, C2.1, C3.1, C4.1, C13.1, C14.1, C23.1, C25.1, C31.1, C34.1, C39.1, C42.1, IC1.1 (VIN), IC2.1 (VIN), IC3.1 (VIN), IC4.1 (VIN), IC5.13 (VIN_1), IC5.14 (VIN_2), IC6.1 (VIN), IC7.13 (VIN_1), IC7.14 (VIN_2), IC8.1 (VIN), IC9.1 (VIN), J1.1, J1.2, J1.3, J1.4, J1.5, J1.6, J15.1, J15.2, J15.3, J19.1, R21.1, R24.2, R32.1, R35.2, R43.1, R48.2
-5V: C32.1, C37.2, C46.2, IC7.5 (BIAS), IC7.10 (AGND), IC7.15 (PGND_1), IC7.16 (PGND_2), IC7.17 (EP), J6.1, J6.2, J6.3, J6.4, J6.5, J6.6, J16.2, J17.2, R34.2, R42.1, R53.2
-10V: C24.1, C28.2, C47.2, IC5.5 (BIAS), IC5.10 (AGND), IC5.15 (PGND_1), IC5.16 (PGND_2), IC5.17 (EP), J4.1, J4.2, J4.3, J4.4, J4.5, J4.6, J16.1, J17.1, R23.2, R31.1, R52.2
CLK_{DAC}: J9.5, J10.5, R55.2, R61.1, U1.5 (SCLK), U2.5 (SCLK), U3.5 (SCLK), U4.5 (SCLK)
DIN_{DAC,AUX}: J9.1, J10.1, R59.2, R65.1, U1.4 (DIN)
DIN_{DAC,BUS}: J9.2, J10.2, R58.2, R64.1, U2.4 (DIN)
DIN_{DAC,PEL,I}: J9.3, J10.3, R57.2, R63.1, U4.4 (DIN)
DIN_{DAC,PEL,V}: J9.4, J10.4, R56.2, R62.1, U3.4 (DIN)
ENABLE_{BUS,AUX}: IC2.8 (EN), J11.2, J12.2, R2.1, R70.2, R71.1
ENABLE_{BUS}: IC1.8 (EN), J11.1, J12.1, R1.1, R72.2, R73.1
ENABLE_{PEL,I}: IC4.8 (EN), J13.2, J14.2, R12.1, R66.1, R68.2
ENABLE_{PEL,V}: IC3.8 (EN), J13.1, J14.1, R11.1, R67.1, R69.2
GND: C1.2, C2.2, C3.2, C4.2, C5.1, C6.1, C7.2, C8.2, C9.1, C10.1, C11.1, C12.1, C13.2, C14.2, C15.1, C16.1, C17.2, C18.2, C19.1, C20.1, C21.1, C22.1, C23.2, C25.2, C26.1, C28.1, C29.2, C30.2, C31.2, C33.1, C34.2, C36.2, C37.1, C38.2, C39.2, C40.1, C41.2, C42.2, C43.2, C44.2, C45.2, C46.1, C47.1, C48.2, C49.2, C50.2, C51.2, D1.1 (K), D2.1 (K), D3.1 (K), D4.1 (K), D5.2 (A), D6.2 (A), IC1.3 (GND), IC1.4 (FB2), IC1.10 (MODE), IC1.11 (VSEL), IC2.3 (GND), IC2.4 (FB2), IC2.10 (MODE), IC2.11 (VSEL), IC3.3 (GND), IC3.4 (FB2), IC3.10 (MODE), IC3.11 (VSEL), IC4.3 (GND), IC4.4 (FB2), IC4.10 (MODE), IC4.11 (VSEL), IC6.3 (GND), IC6.4 (FB2), IC6.10 (MODE), IC6.11 (VSEL), IC8.3 (GND), IC8.4 (FB2), IC8.10 (MODE), IC8.11 (VSEL), IC9.3 (GND), IC9.4 (FB2), IC9.10 (MODE), IC9.11 (VSEL), J7.1, J7.2, J7.3, J7.4, J7.5, J7.6, J8.1, J8.2, J8.3, J8.4, J8.5, J8.6, J15.4, J15.5, J15.6, J16.6, J17.6, J18.5, J18.6, J19.2, L6.2, L8.2, R1.2, R2.2, R6.2, R8.2, R11.2, R12.2, R16.2, R18.2, R22.2, R26.1, R28.2, R30.2, R33.2, R38.2, R40.1, R41.2, R46.2, R60.2, R61.2, R62.2, R63.2, R64.2, R65.2, R66.2, R67.2, R71.2, R73.2, RV1.1, RV2.1, RV3.1, U1.2 (GND), U2.2 (GND), U3.2 (GND), U4.2 (GND)
unnamed: D1.2 (A), R48.1
unnamed: D2.2 (A), R49.1
unnamed: D3.2 (A), R50.1
unnamed: D4.2 (A), R51.1
unnamed: D5.1 (K), R52.1
unnamed: D6.1 (K), R53.1
unnamed: IC1.5 (FB), R9.1
unnamed: IC1.7 (PG), R3.2
unnamed: C5.2, IC1.9 (SS/TR)
unnamed: IC1.2 (SW), L1.1
unnamed: IC2.5 (FB), R10.1
unnamed: IC2.7 (PG), R4.2
unnamed: C6.2, IC2.9 (SS/TR)
unnamed: IC2.2 (SW), L2.1
unnamed: IC3.5 (FB), R15.2, R16.1, R19.1
unnamed: IC3.7 (PG), R13.1
unnamed: C15.2, IC3.9 (SS/TR)
unnamed: IC3.2 (SW), L3.1
unnamed: IC4.5 (FB), R17.2, R18.1, R20.1
unnamed: IC4.7 (PG), R14.1
unnamed: C16.2, IC4.9 (SS/TR)
unnamed: IC4.2 (SW), L4.1
unnamed: C27.2, IC5.3 (CBOOT)
unnamed: IC5.12 (EN), R24.1
unnamed: C30.1, IC5.9 (FB), R30.1, R31.2
unnamed: IC5.8 (PGOOD), R26.2
unnamed: C27.1, IC5.1 (SW_1), IC5.2 (SW_2), L6.1
unnamed: IC5.6 (SYNC), R22.1, R23.1
unnamed: C24.2, IC5.4 (VCC)
unnamed: IC6.8 (EN), R21.2
unnamed: IC6.5 (FB), R27.2, R28.1, R29.1
unnamed: IC6.7 (PG), R25.1
unnamed: C26.2, IC6.9 (SS/TR)
unnamed: IC6.2 (SW), L5.1
unnamed: C35.2, IC7.3 (CBOOT)
unnamed: IC7.12 (EN), R35.1
unnamed: C38.1, IC7.9 (FB), R41.1, R42.2
unnamed: IC7.8 (PGOOD), R40.2
unnamed: C35.1, IC7.1 (SW_1), IC7.2 (SW_2), L8.1
unnamed: IC7.6 (SYNC), R33.1, R34.1
unnamed: C32.2, IC7.4 (VCC)
unnamed: IC8.8 (EN), R32.2
unnamed: IC8.5 (FB), R37.2, R38.1, R39.1
unnamed: IC8.7 (PG), R36.1
unnamed: C33.2, IC8.9 (SS/TR)
unnamed: IC8.2 (SW), L7.1
unnamed: IC9.8 (EN), R43.2
unnamed: IC9.5 (FB), R45.2, R46.1, R47.1
unnamed: IC9.7 (PG), R44.1
unnamed: C40.2, IC9.9 (SS/TR)
unnamed: IC9.2 (SW), L9.1
unnamed: R5.2, R6.1
unnamed: R7.2, R8.1
unnamed: R29.2, RV1.2
unnamed: R39.2, RV2.2
unnamed: R47.2, RV3.2
unnamed: R10.2, TP3.1, U1.1 (VOUT)
unnamed: R9.2, TP4.1, U2.1 (VOUT)
unnamed: R19.2, TP7.1, U3.1 (VOUT)
unnamed: R20.2, TP8.1, U4.1 (VOUT)
Peltier_{I}: C18.1, C51.1, IC4.6 (VOS), J18.4, L4.2, R14.2, R17.1, TP6.1
Peltier_{V}: C17.1, C50.1, IC3.6 (VOS), J18.3, L3.2, R13.2, R15.1, TP5.1
SYNC_{DAC}: J9.6, J10.6, R54.2, R60.1, U1.6 (SYNC), U2.6 (SYNC), U3.6 (SYNC), U4.6 (SYNC)
VBUS: C7.1, C48.1, IC1.6 (VOS), J18.1, L1.2, R3.1, R5.1, TP1.1
V_{BUS,AUX}: C8.1, C49.1, IC2.6 (VOS), J18.2, L2.2, R4.1, R7.1, TP2.1
